OPRobots/KiCADLibraries/custom_footprints/3d_models/TSOP38238 90º.step

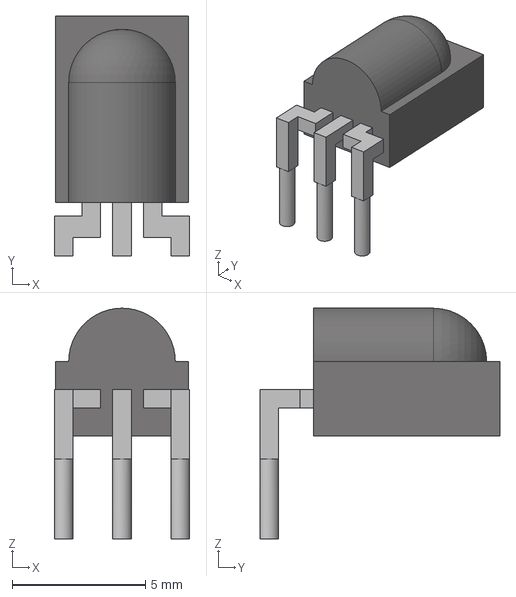
[picture p1: CAD file, 2025-01-05]
custom_footprints/3d_models/TSOP38238 90º.step
5.08 x 9.00 x 8.65 mm
