OPRobots/KiCADLibraries/custom_footprints/3d_models/WS2812D 5mm LED Staggered Pins.step

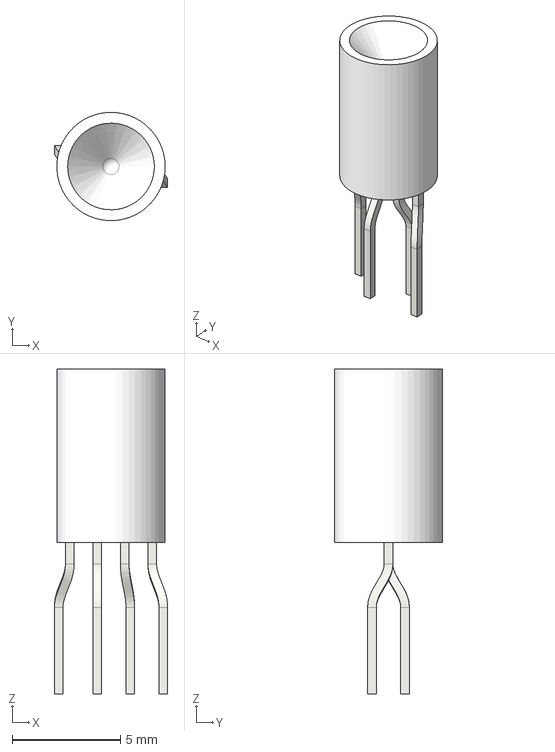
[picture p2: CAD file, 2025-01-05]
custom_footprints/3d_models/WS2812D 5mm LED Staggered Pins.step
5.23 x 5.00 x 15.0 mm
