OPRobots/KiCADLibraries/custom_footprints/3d_models/IR TSSP77038ETR.step

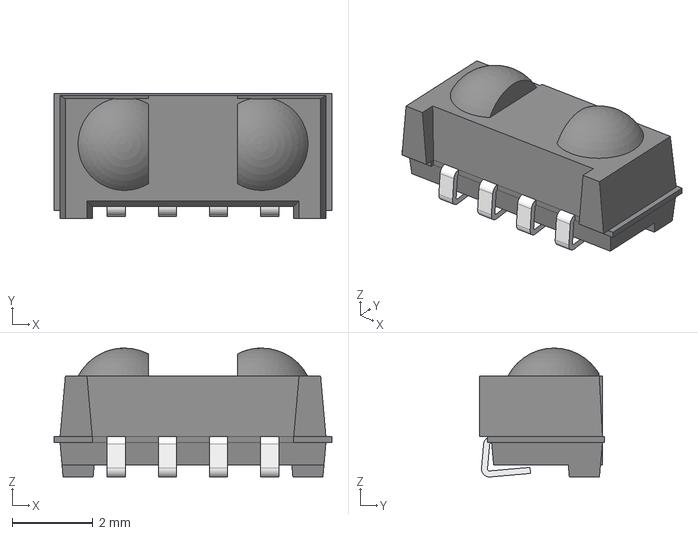
[picture p3: CAD file, 2025-01-01]
custom_footprints/3d_models/IR TSSP77038ETR.step
6.90 x 3.10 x 3.20 mm
