OPRobots/KiCADLibraries/custom_footprints/3d_models/ZoroBot3_Motor_conn-2P-1.25DSA.STEP

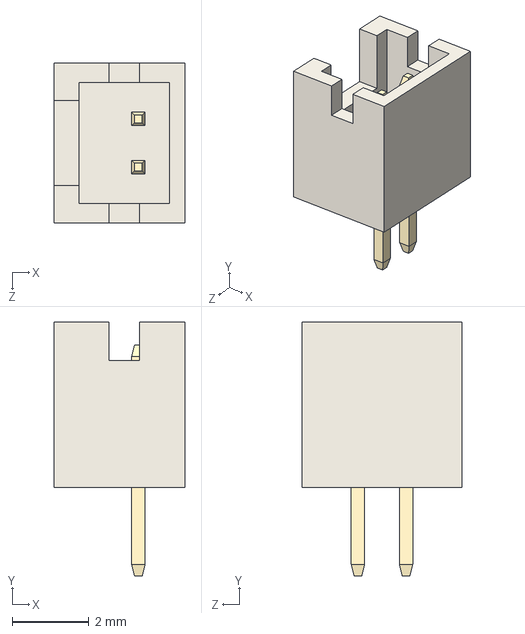
[picture p4: CAD file, 2025-01-01]
custom_footprints/3d_models/ZoroBot3_Motor_conn-2P-1.25DSA.STEP
3.40 x 6.60 x 4.15 mm
