OPRobots/KiCADLibraries/custom_footprints/3d_models/IRStart - Module.step

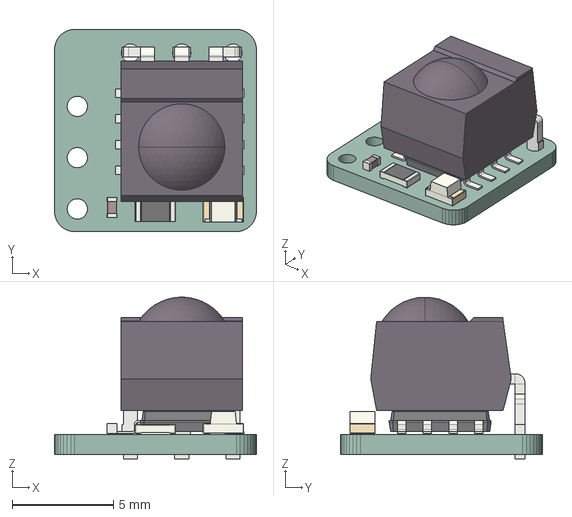
[picture p5: CAD file, 2024-08-06]
custom_footprints/3d_models/IRStart - Module.step
10.0 x 10.0 x 8.00 mm
PCB
