OPRobots/KiCADLibraries/custom_footprints/3d_models/BT_1cm.step

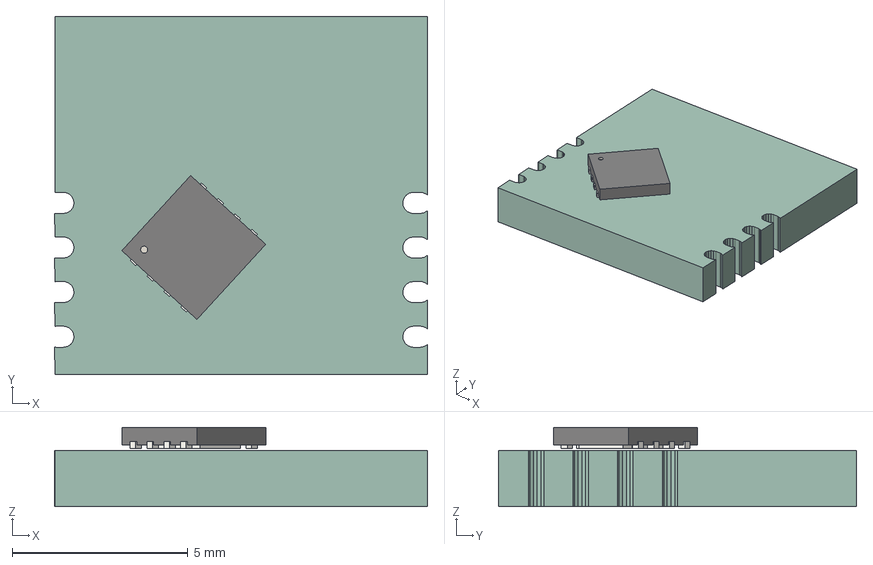
[picture p6: CAD file, 2024-08-06]
custom_footprints/3d_models/BT_1cm.step
10.6 x 10.2 x 2.25 mm
PCB
