OPRobots/KiCADLibraries/custom_footprints/3d_models/TSOP4838.step

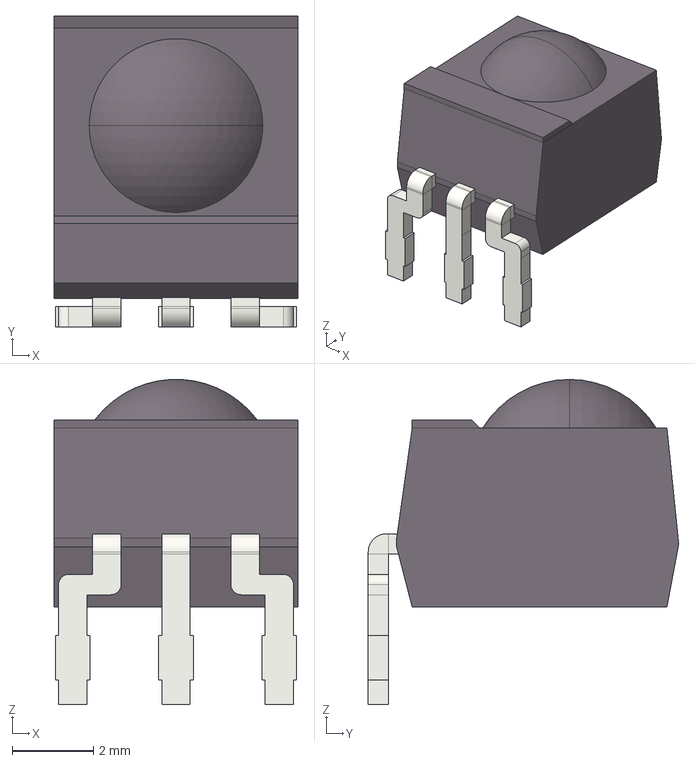
[picture p7: CAD file, 2024-05-24]
custom_footprints/3d_models/TSOP4838.step
6.00 x 7.64 x 8.00 mm
