OPRobots/KiCADLibraries/custom_footprints/3d_models/xt30.step

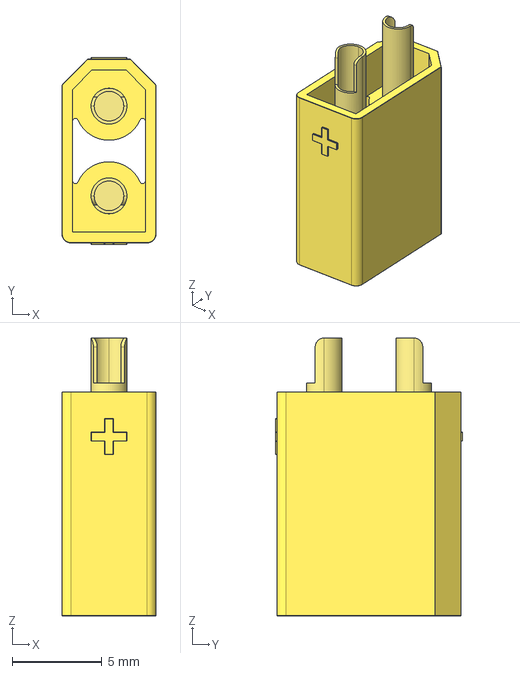
[picture p8: CAD file, 2024-02-21]
custom_footprints/3d_models/xt30.step
5.25 x 10.4 x 15.5 mm
