OPRobots/KiCADLibraries/custom_footprints/3d_models/ITR8307.step

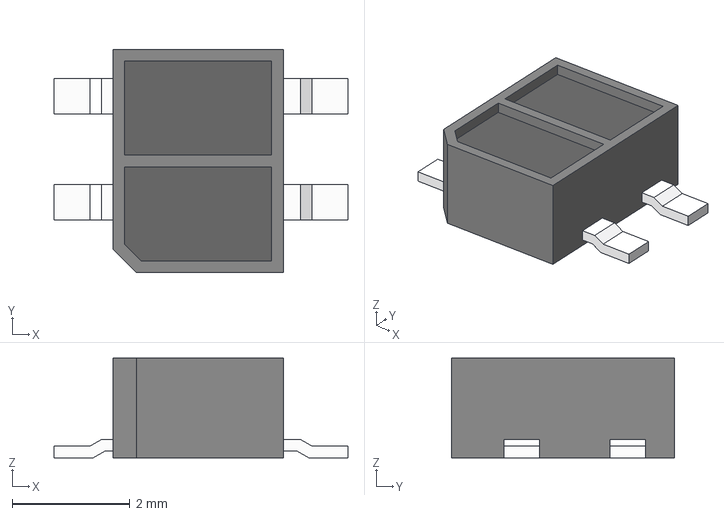
[picture p9: CAD file, 2024-02-21]
custom_footprints/3d_models/ITR8307.step
5.00 x 3.80 x 1.70 mm
