OPRobots/KiCADLibraries/custom_footprints/3d_models/FPC-8.stp

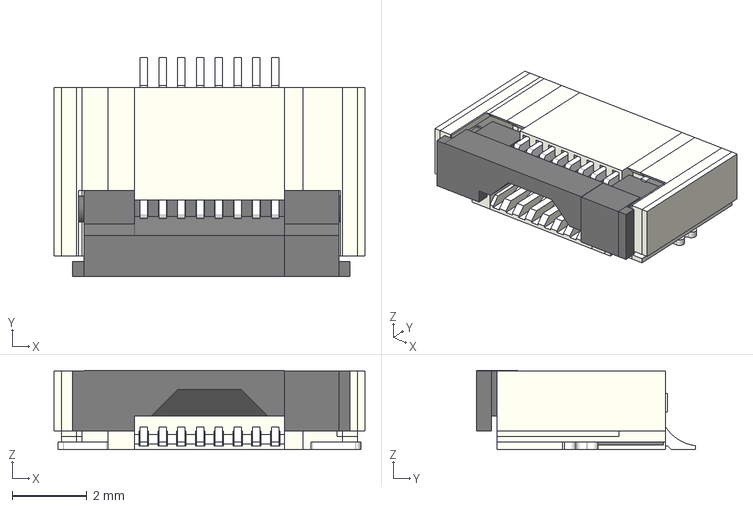
[picture p10: CAD file, 2024-02-21]
custom_footprints/3d_models/FPC-8.stp
8.30 x 5.85 x 2.11 mm
