OPRobots/KiCADLibraries/custom_footprints/3d_models/ESP32-C3 supermini v5.step

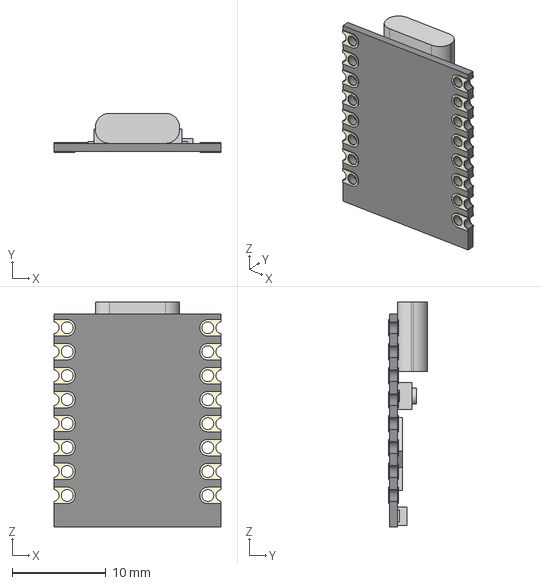
[picture p11: CAD file, 2024-01-15]
custom_footprints/3d_models/ESP32-C3 supermini v5.step
17.8 x 4.20 x 24.0 mm
