OPRobots/KiCADLibraries/custom_footprints/3d_models/USB-C ST-Link USART.stp

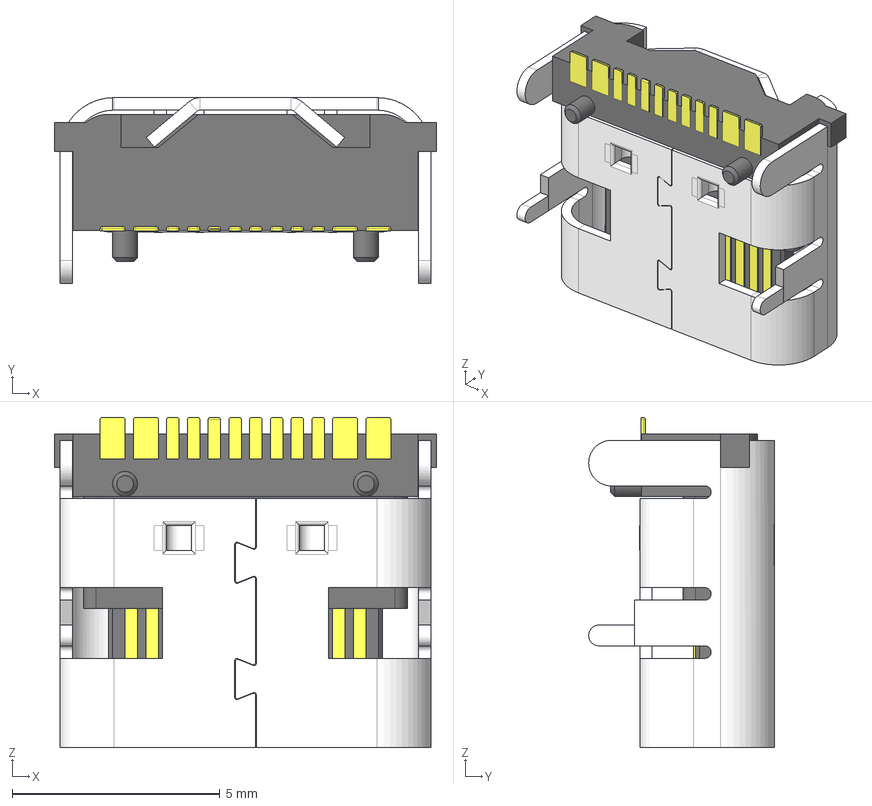
[picture p12: CAD file, 2023-09-01]
custom_footprints/3d_models/USB-C ST-Link USART.stp
9.20 x 4.47 x 7.95 mm
