OPRobots/KiCADLibraries/custom_footprints/3d_models/Mini360.step

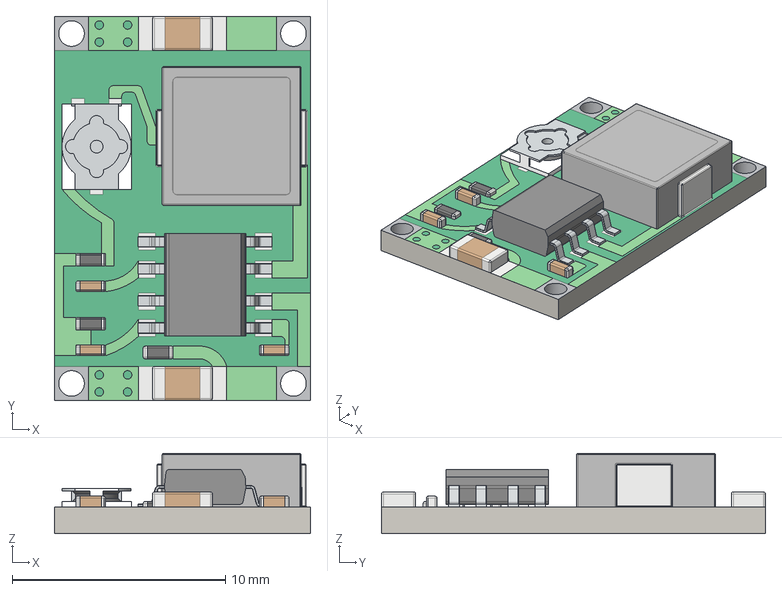
[picture p13: CAD file, 2023-09-01]
custom_footprints/3d_models/Mini360.step
12.0 x 18.0 x 3.75 mm
