OPRobots/KiCADLibraries/custom_footprints/3d_models/BTN_SMD_3x6x2.5mm.step

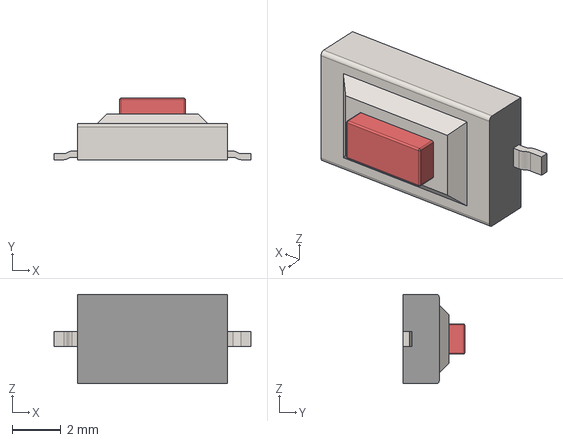
[picture p14: CAD file, 2023-09-01]
custom_footprints/3d_models/BTN_SMD_3x6x2.5mm.step
8.05 x 2.51 x 3.66 mm
