OPRobots/KiCADLibraries/custom_footprints/3d_models/JST - XH - Thru (V) - 4Pin - 2.54mm.stp

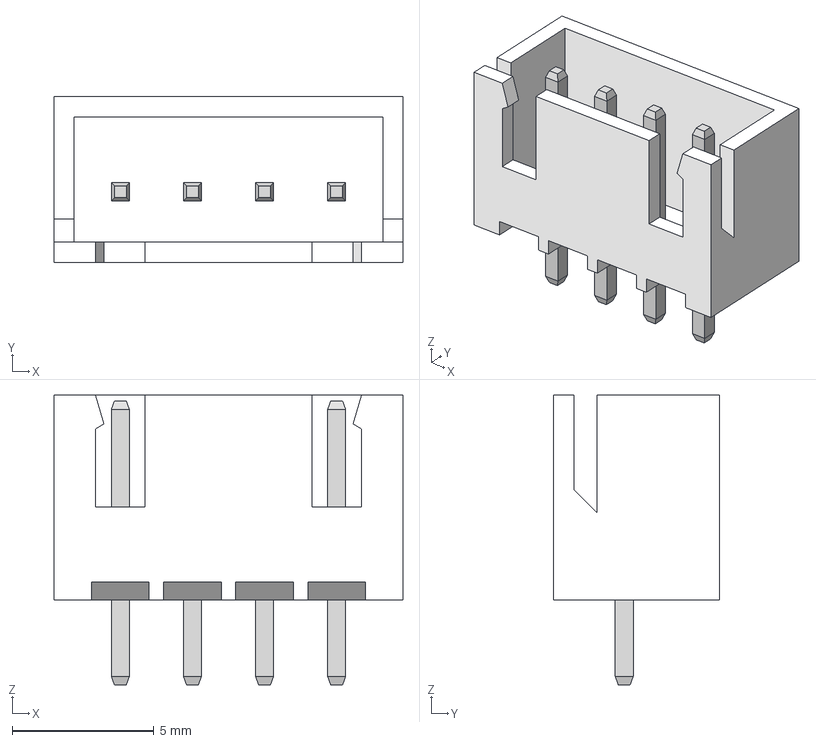
[picture p15: CAD file, 2023-09-01]
custom_footprints/3d_models/JST - XH - Thru (V) - 4Pin - 2.54mm.stp
12.3 x 5.84 x 10.2 mm
