OPRobots/KiCADLibraries/custom_footprints/3d_models/Switch6P.step

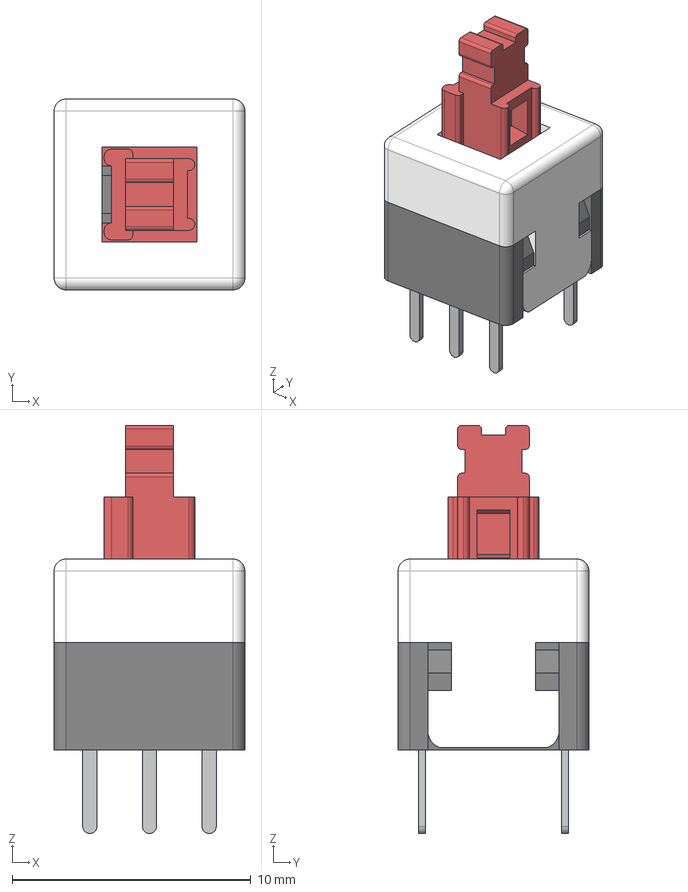
[picture p16: CAD file, 2023-09-01]
custom_footprints/3d_models/Switch6P.step
8.00 x 8.00 x 17.1 mm
Push Switch_8x8_6pin_with Lock
Push Switch_8x8_6pin_with Lock001
Push Switch_8x8_6pin_with Lock002
Push Switch_8x8_6pin_with Lock003
Push Switch_8x8_6pin_with Lock004
Push Switch_8x8_6pin_with Lock005
Push Switch_8x8_6pin_with Lock006
Push Switch_8x8_6pin_with Lock007
Push Switch_8x8_6pin_with Lock008
