OPRobots/KiCADLibraries/custom_footprints/3d_models/Crystal_SMD_5032-2pin_5.0x3.2mm.step

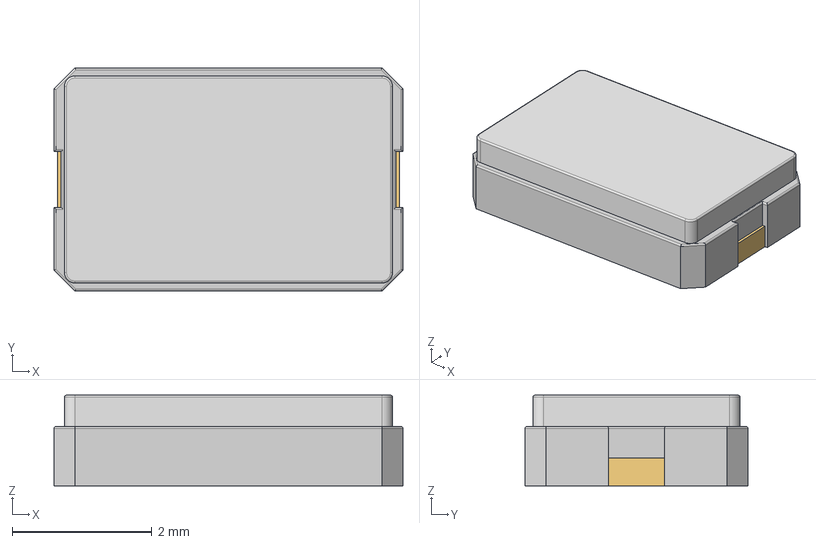
[picture p17: CAD file, 2023-09-01]
custom_footprints/3d_models/Crystal_SMD_5032-2pin_5.0x3.2mm.step
5.00 x 3.20 x 1.30 mm
User Library-ABM3-1_Fillet002
User Library-ABM3-1_Fillet001
User Library-ABM3-1_Pad001
User Library-ABM3-1_Pad002
