OPRobots/KiCADLibraries/(commit log)

2023-08-25 Añade varios symbols y footprints
2023-08-29 Corrige footprint de SimpleFOCMini
2023-09-01 Añade nuevos Symbols y modelos 3D
    [BTN_SMD_3x6x2.5mm.step, Crystal_SMD_5032-2pin_5.0x3.2mm.step, JST - XH - Thru (V) - 4Pin - 2.54mm.stp, Mini360.step, Switch6P.step, USB-C ST-Link USART.stp]
2024-01-15 Añade ESP32_supermini, QRE1113, RZ7886 y modelos 3D
    [ESP32-C3 supermini v5.step]
2024-01-17 Añade modelos 3D de conector FLEX e ITR
    [FPC-8.stp, ITR8307.step]
2024-02-21 Añade led RGB staggered
2024-02-21 Añade librerias XT30 y DC-DC CN3903
    [xt30.step]
2024-04-21 Corrige simbolo ESP32_supermini
2024-05-23 Añade footprints de `Arduino as ISP`, SOP8 y SOIC-8W
2024-05-24 Añade modelo 3D de TSOP4838
    [TSOP4838.step]
2024-08-06 Actualiza libreria con Fujitora2
    [BT_1cm.step, IRStart - Module.step]
2024-09-05 Añade huella QRE1113 para FujitoraBot2
2024-12-29 Actualiza link de Aliexpress de LDO_ME6211C33 y añade recepor IR SMD TSSP77038TR
2024-12-31 Añade TB6612FNG, STM32F405RGT6 Y AD8418
2024-12-31 Añade Generic SmallButton y Generic Switch ONOFF
2025-01-01 Crea las huellas necesarias para ZoroBot3 Rebuild y añade modelos 3D faltantes.
    [IR TSSP77038ETR.step, ZoroBot3_Motor_conn-2P-1.25DSA.STEP]
2025-01-04 Añade esquemas y huellas de GP2Y0D810Z0F_Digital_Sensor y ST7789V_LCD_RGB_135x240
2025-01-04 Añade huella y modelo 3D de Receptor IR a 90º
    [TSOP38238 90º.step]
2025-01-04 Añade huella y modelo 3D de leds RGB 5mm
    [WS2812D 5mm LED Staggered Pins.step]
2025-01-05 Añade encoders AS5145B y ajusta huellas ya existentes para ZoroBot3
